dr-fischer/wheeCAIR/hardware/photos/photoEnclosure.png

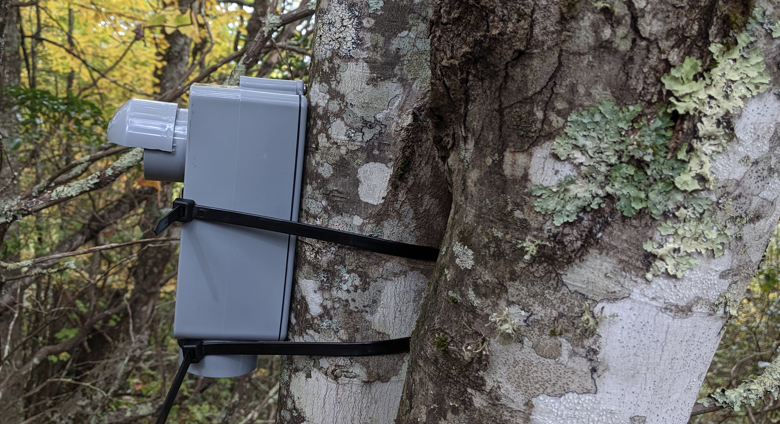
hardware/photos/photoEnclosure.png
