dr-fischer/wheeCAIR/hardware/photos/photoSensors.png

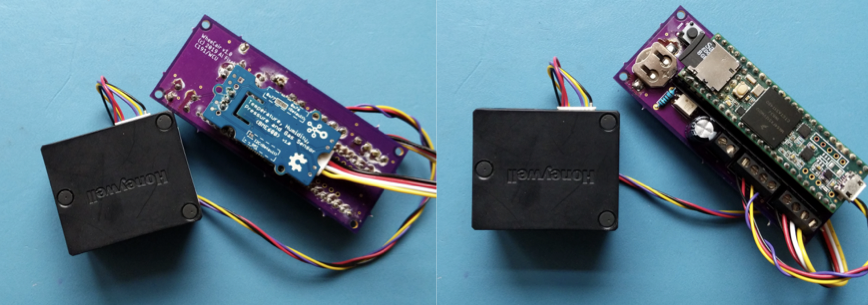
hardware/photos/photoSensors.png
