dr-fischer/wheeCAIR/hardware/programBlockDiagram.png

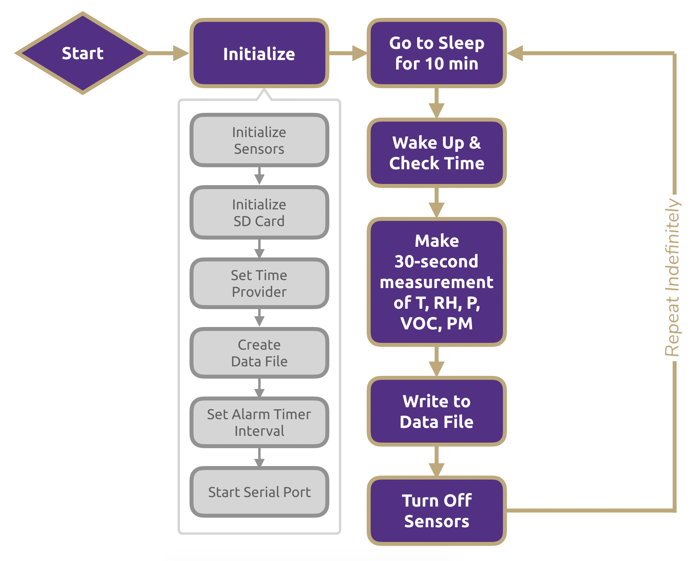
hardware/programBlockDiagram.png
