dr-fischer/wheeCAIR/hardware/sensorBlockDiagram.png

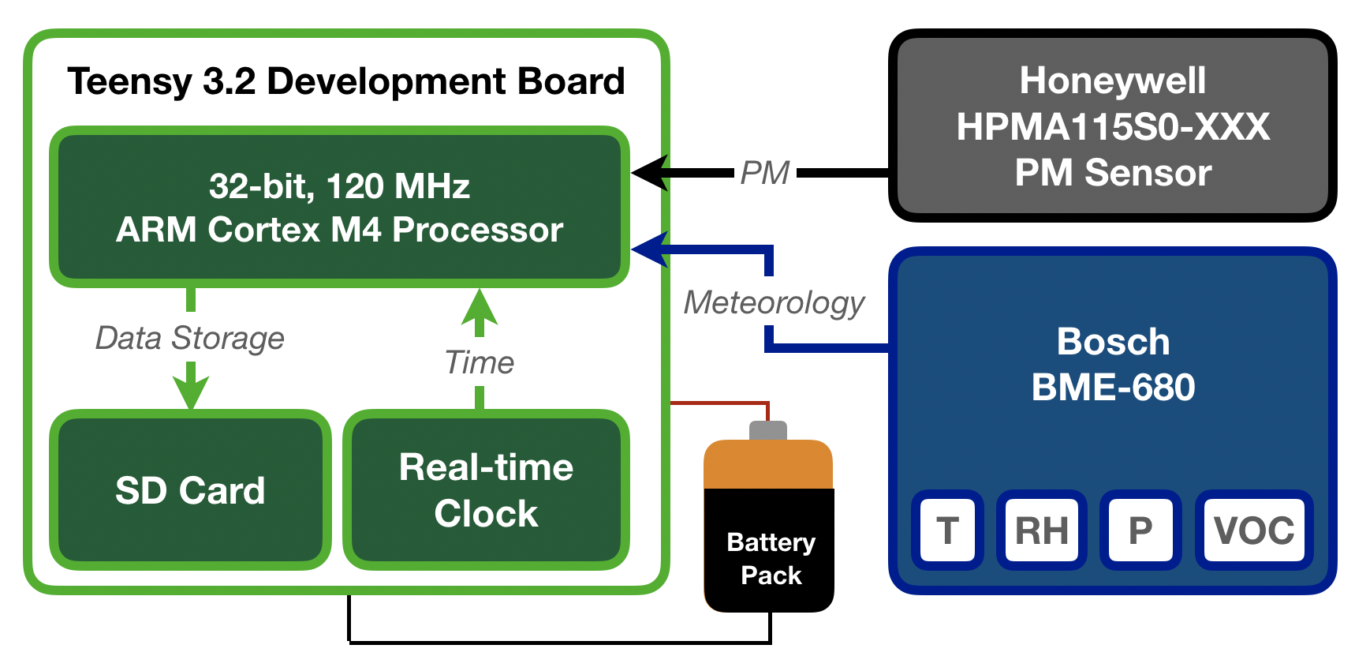
hardware/sensorBlockDiagram.png
