dr-fischer/wheeCAIR/data/grsm-purchase/2019/img/README.md

Webcam Images
============

Location: Air Web Cam Photo, View from Purchase Knob ELC, Great Smoky Mountains National Park
Available at: [https://npgallery.nps.gov/AirWebCams/grpk](https://npgallery.nps.gov/AirWebCams/grpk)
