dr-fischer/wheeCAIR/data/grsm-purchase/2019/img/grpk201910301100.jpg

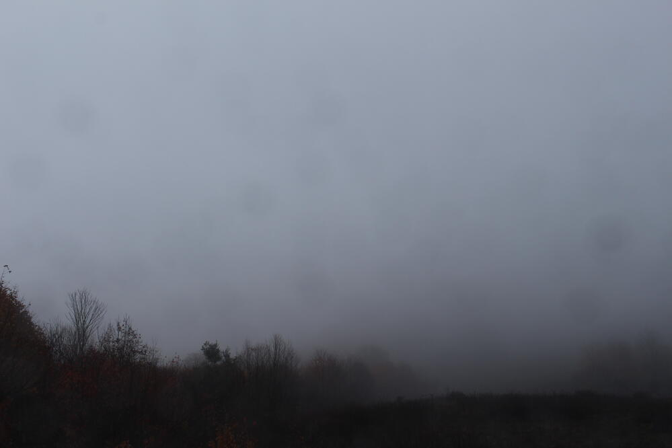
data/grsm-purchase/2019/img/grpk201910301100.jpg
