dr-fischer/wheeCAIR/data/grsm-purchase/2019/plots/rh_boxplot.pdf

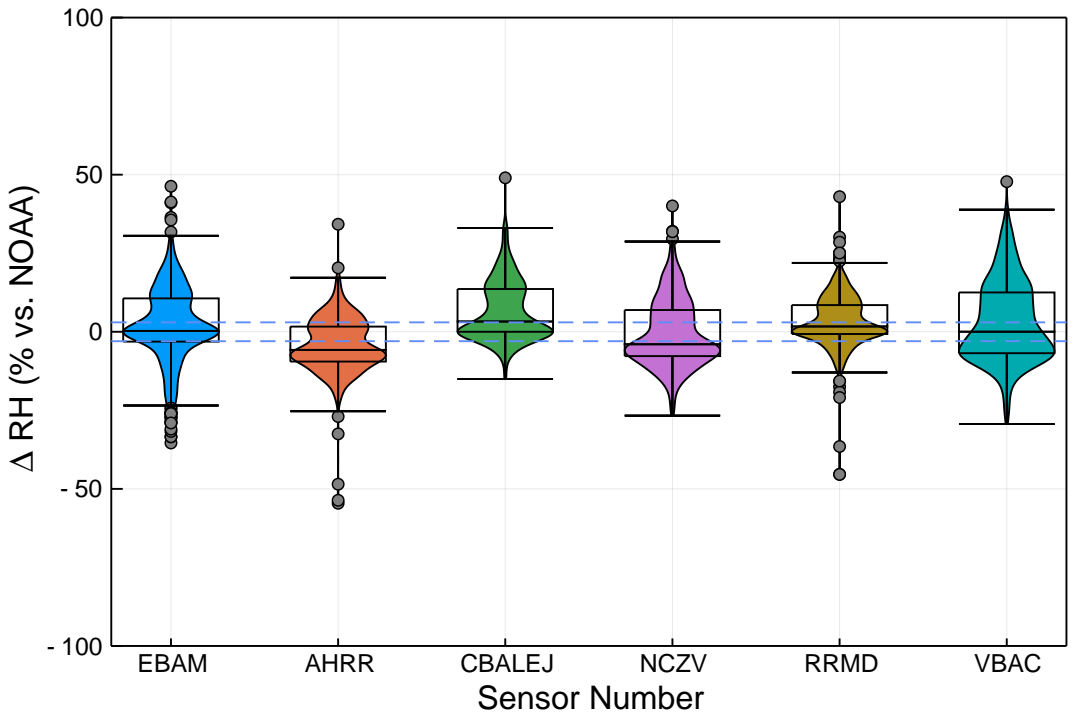
[picture p6: page 1]
EBAM; AHRR; CBALEJ; NCZV; RRMD; VBAC -100; Sensor Number

∆ RH (% vs. NOAA)
