dr-fischer/wheeCAIR/data/grsm-purchase/2019/plots/temp_boxplot.pdf

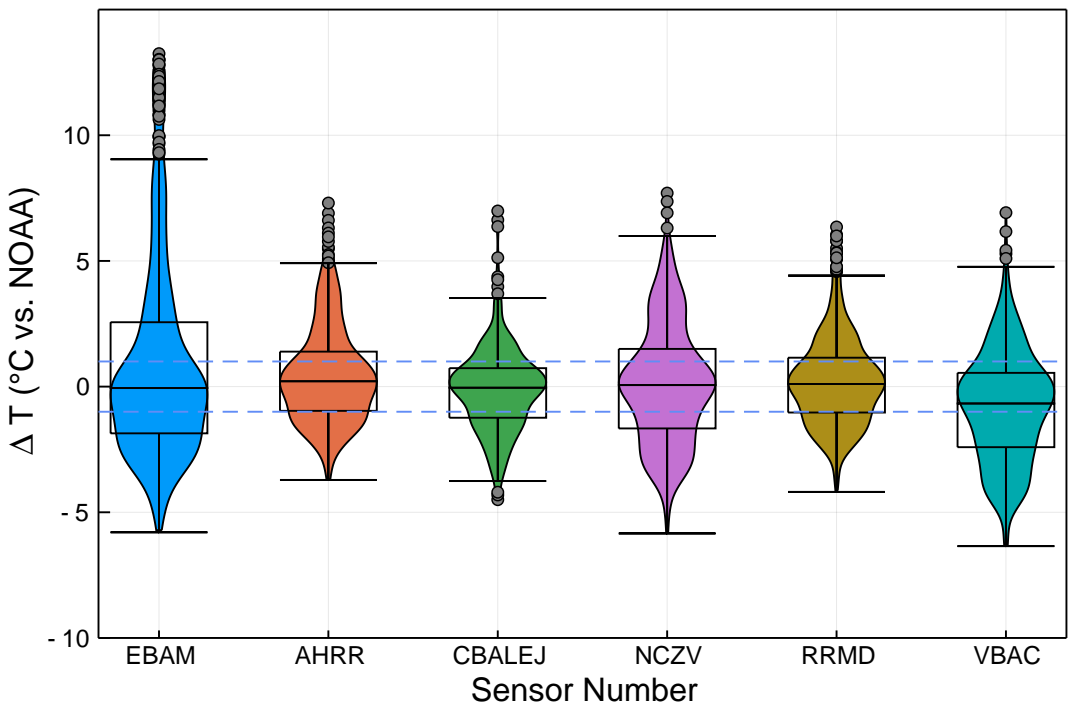
[picture p7: page 1]
EBAM; AHRR; CBALEJ; NCZV; RRMD; VBAC -10; Sensor Number; ∆ T (°C vs. NOAA)
