dr-fischer/wheeCAIR/data/grsm-purchase/2019/plots/temp_scatter.pdf

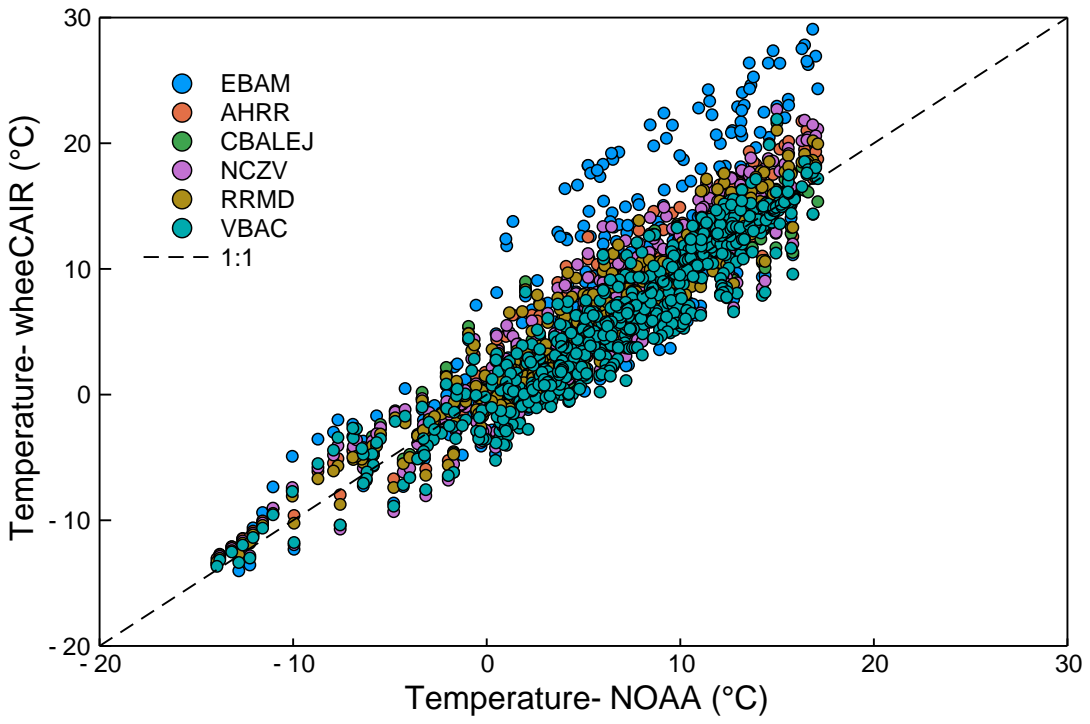
[picture p8: page 1]
Temperature-NOAA (°C); Temperature-wheeCAIR (°C); EBAM AHRR CBALEJ NCZV RRMD VBAC 1:1
