dr-fischer/wheeCAIR/data/grsm-purchase/2019/plots/temp_timeseries.pdf

### EBAM AHRR

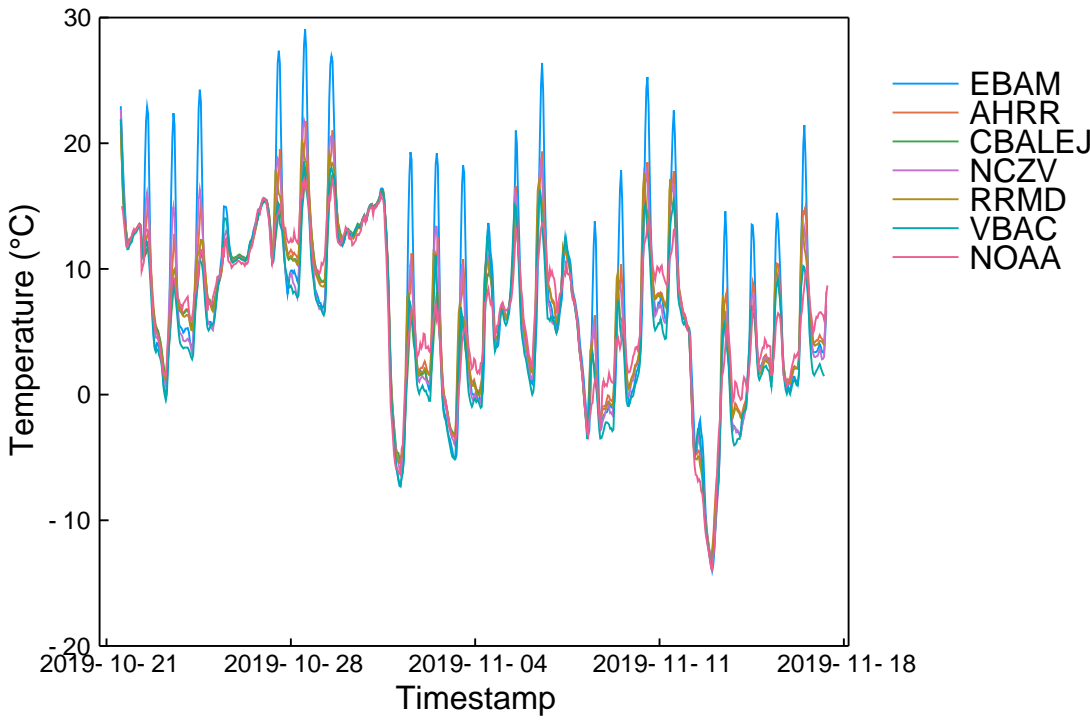
[picture p9: page 1]
Timestamp; Temperature (°C); CBALEJ NCZV RRMD VBAC NOAA
