dr-fischer/wheeCAIR/data/grsm-purchase/2019/plots/pm_scatter.pdf

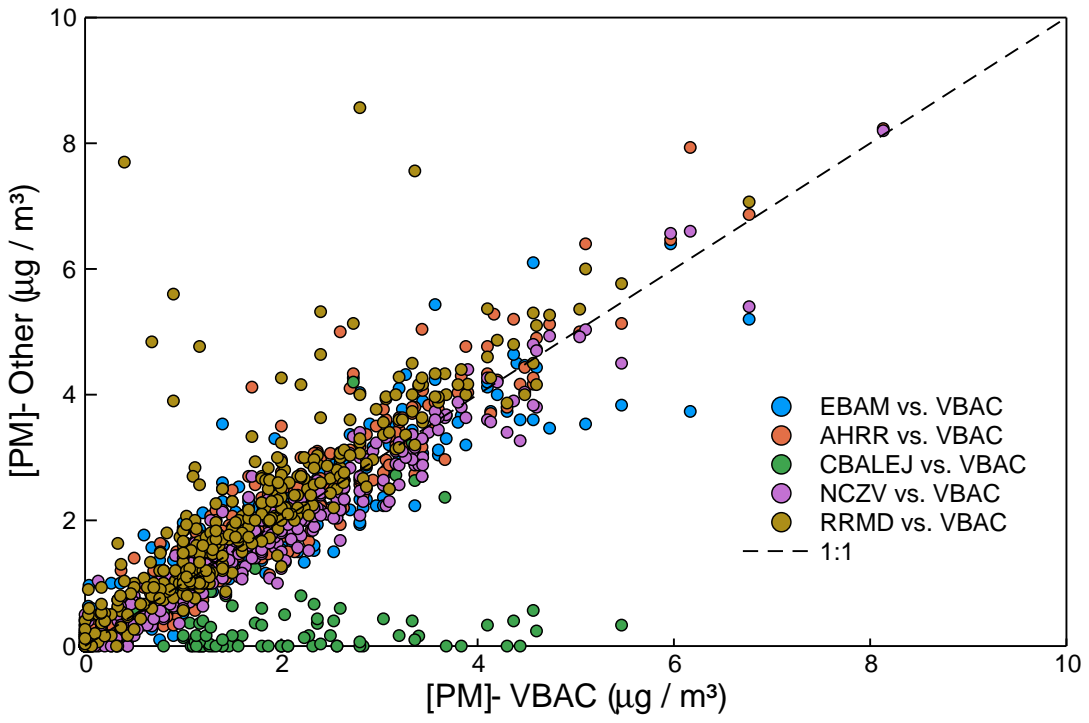
[picture p10: page 1]
-VBAC (µg / m³)

[PM] Other (µg / m³) -

EBAM vs. VBAC
AHRR vs. VBAC
CBALEJ vs. VBAC
NCZV vs. VBAC
RRMD vs. VBAC
