dr-fischer/wheeCAIR/data/grsm-purchase/2019/plots/pm_timeseries.pdf

### EBAM AHRR

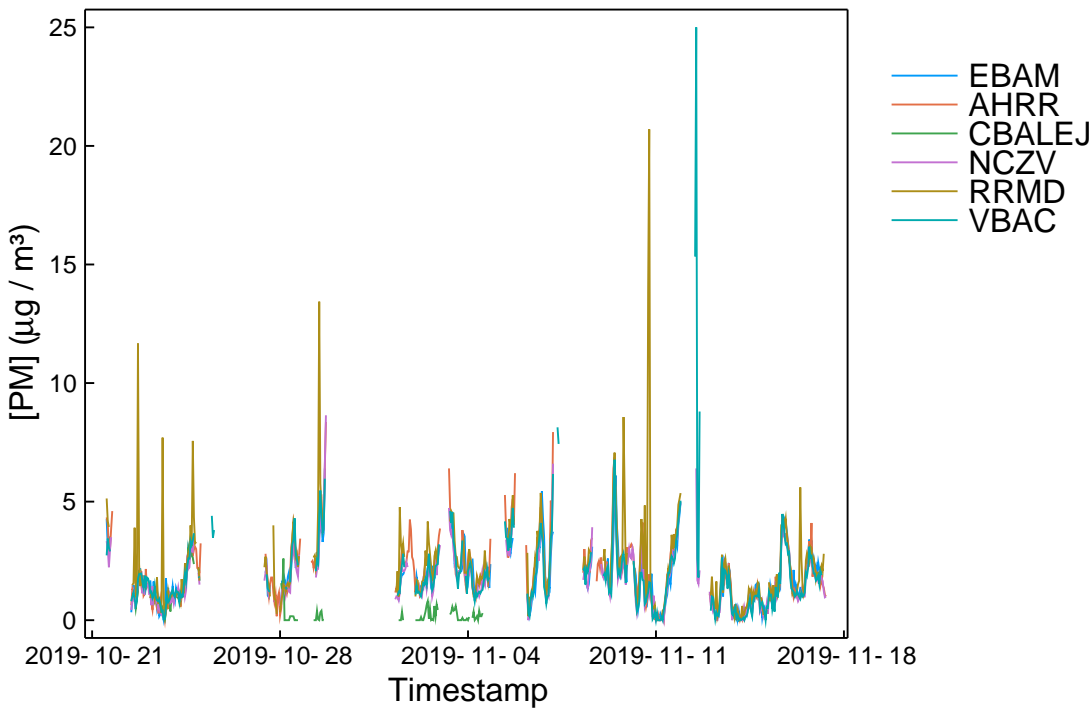
[picture p11: page 1]
Timestamp; CBALEJ NCZV RRMD VBAC
