dr-fischer/wheeCAIR/data/grsm-purchase/2019/plots/rh_scatter.pdf

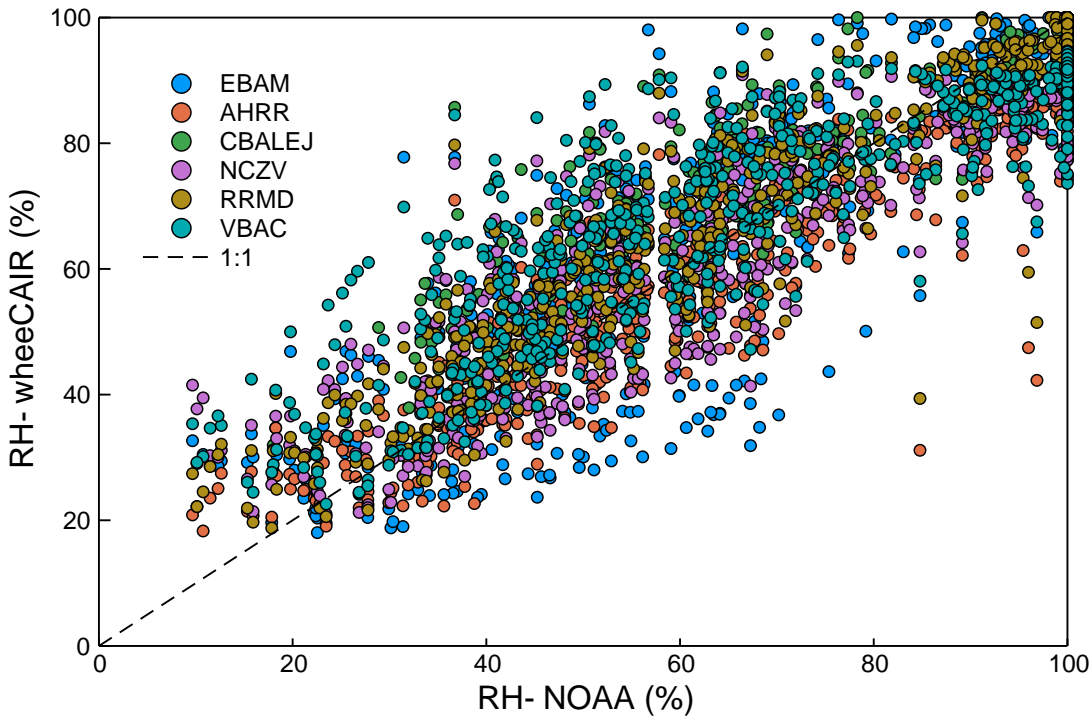
[picture p12: page 1]
RH-NOAA (%); RH-wheeCAIR (%); EBAM AHRR CBALEJ NCZV RRMD VBAC 1:1
