dr-fischer/wheeCAIR/(commit log)

2019-11-19 add noaa data subset
    [noaa_data.csv]
2019-11-20 reorganize directory structure
    [noaa_data.csv]
2019-11-20 udpate directory structure
    [noaa_data.csv]
2019-11-20 organize and average
    [20191021_MACK_10MinAvg.csv, noaa_data.csv, noaa_data_10minAvg.csv]
2019-11-20 noaa folder
    [noaa_data_10minAvg.csv]
2020-02-21 update MACK data
    [20191021_MACK_10MinAvg.csv]
2020-03-09 cleaning up
    [noaa_data_10minAvg.csv]
2021-06-04 fix checksum fail: report -999
    [wheeCAIR.h, wheeCAIR.ino, wheeCAIR_serial.h, wheeCAIR_serial.ino]
2021-06-08 report -999 on checksum fail
    [wheeCAIR_serial.h]
